nitin19011/milo-hardware/cad/generation/README.txt

Run generation scripts from this folder so their work/ and outputs/ paths resolve.
Original battery sleeve is in inputs/.
Historical scripts are retained for provenance; some previews still refer to original machine-specific fonts/paths and may need adaptation.
Existing printable STL files are under cad/glove, cad/mic and cad/battery.
Do not use MakerBot jobs on another printer without checking settings.
