nitin19011/milo-hardware/docs/analysis/candidate_data_20261025/README.txt

25 OCTOBER CANDIDATE DATA REVIEW

Original recording ZIP unchanged.
141 accepted gesture brackets, 603.043 seconds explicit everyday activity.
All IMU reads valid, no clipping, no flex ADC rails, no firmware queue drops.
21 observed forward-gap samples include reordering; only 13 unique sequence numbers are absent.
One restart occurred before the first gesture label.

Hold 4 short Come and 5 short overhand brackets for operator review; do not relabel them as negatives.
The continuous raw stream and nearby context retain motion outside some short brackets.
Remaining 132 gesture brackets are provisionally unflagged, not a claim of perfect labels.
No independent held-out session is present. No detector has been trained or 99% recall established.
