nitin19011/milo-hardware/cad/battery/battery_cap_preview.png

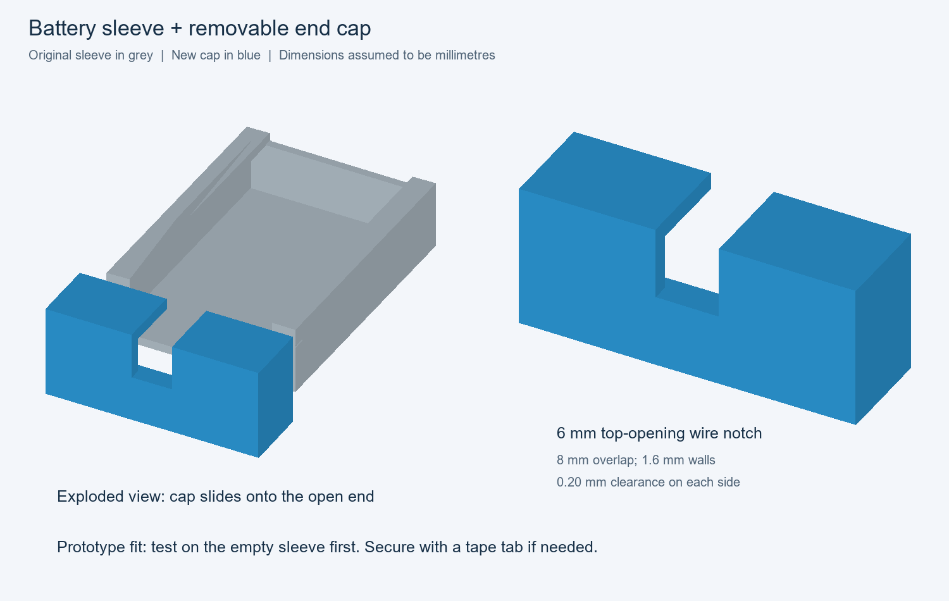
cad/battery/battery_cap_preview.png
