nitin19011/milo-hardware/cad/battery/Battery_flush_preview.png

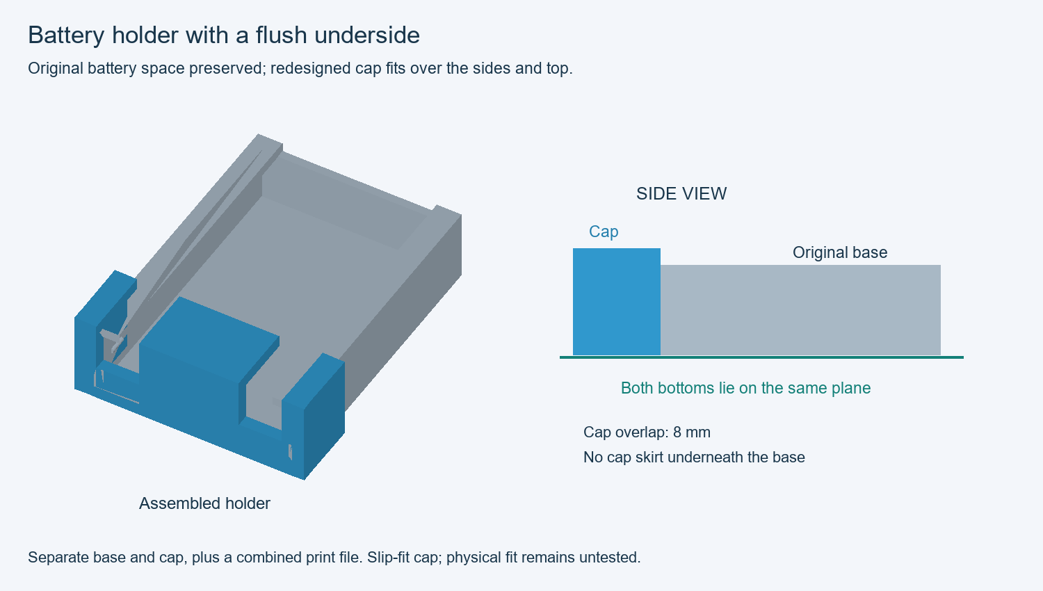
cad/battery/Battery_flush_preview.png
