nitin19011/milo-hardware/cad/glove/Glove_ESP_housing_labelled_concept.png

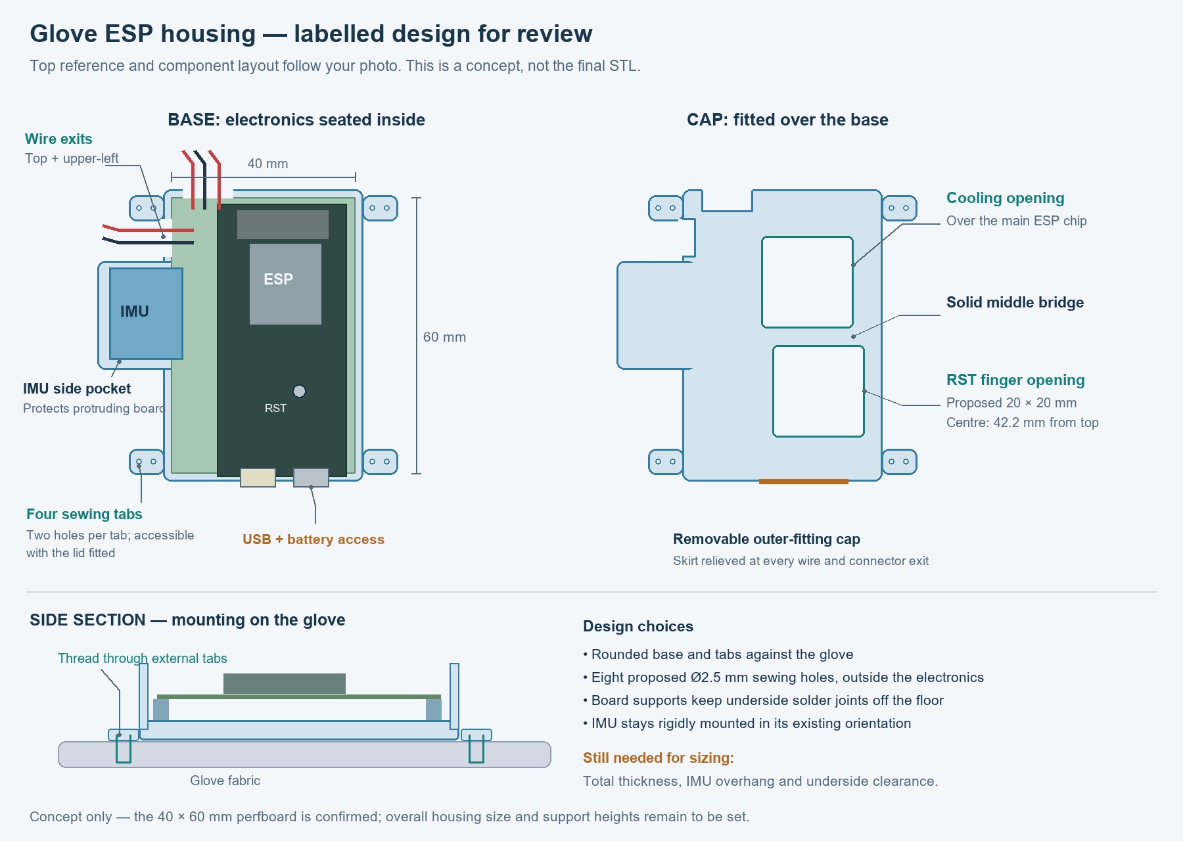
cad/glove/Glove_ESP_housing_labelled_concept.png
