nitin19011/milo-hardware/cad/glove/Glove_ESP_housing_labelled_concept_v2.png

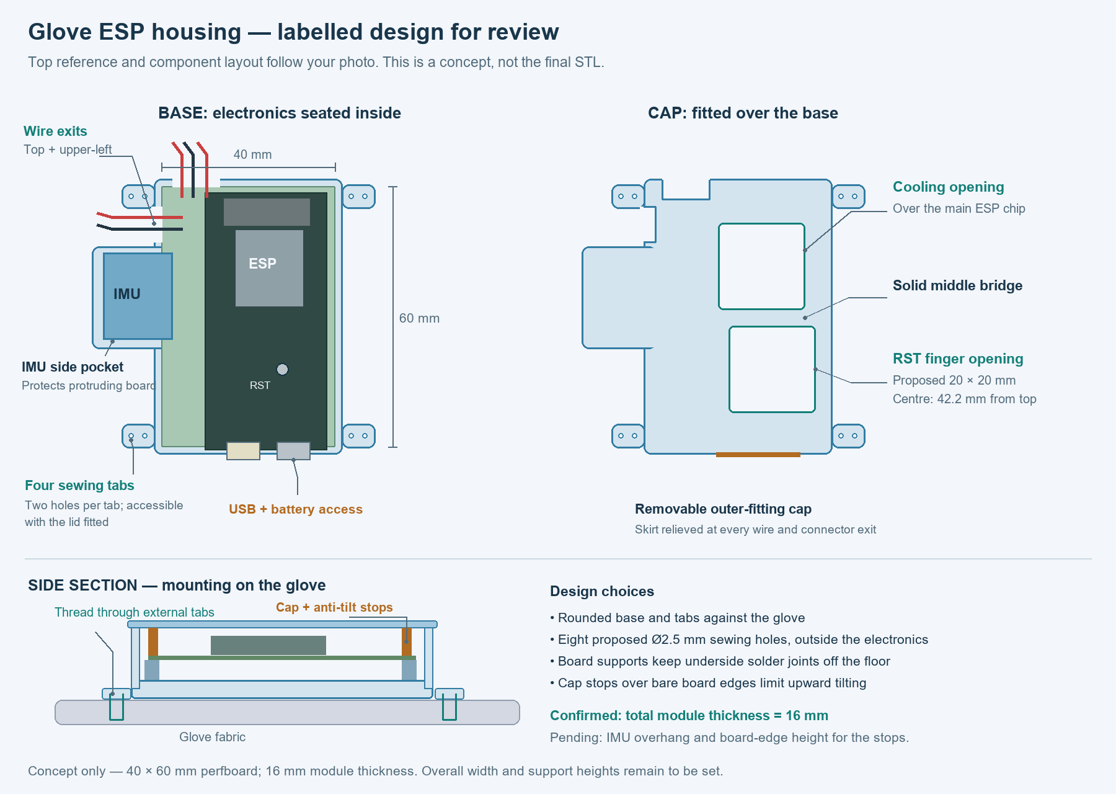
cad/glove/Glove_ESP_housing_labelled_concept_v2.png
