nitin19011/milo-hardware/cad/glove/Glove_ESP_IMU_vent_concept_v4.png

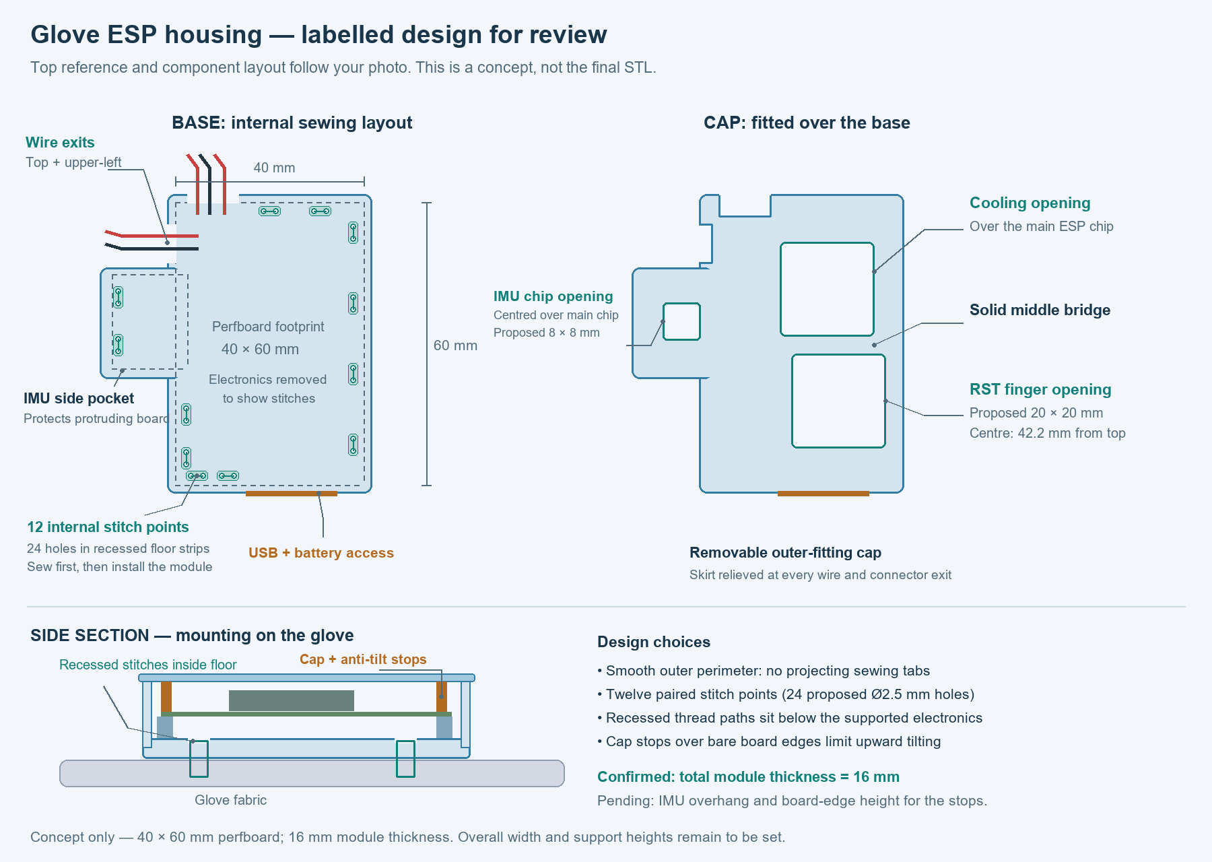
cad/glove/Glove_ESP_IMU_vent_concept_v4.png
