nitin19011/milo-hardware/cad/glove/Glove_housing_cap_v2_preview.png

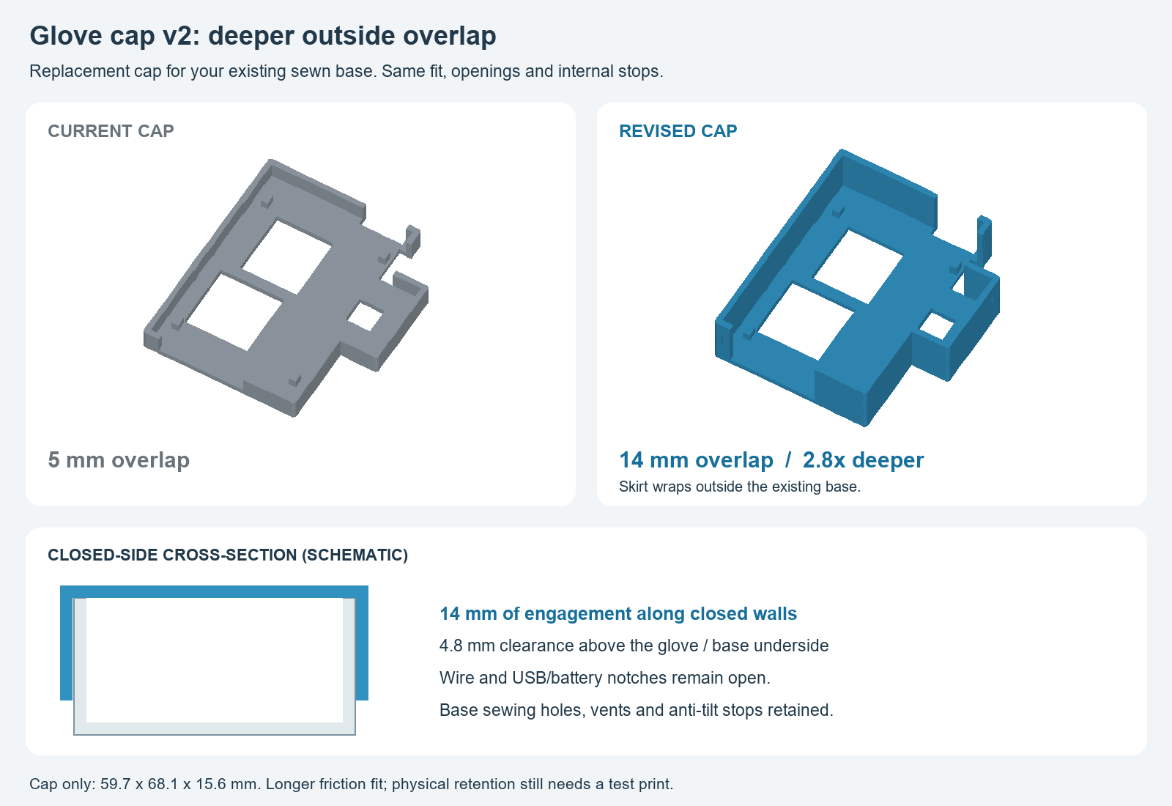
cad/glove/Glove_housing_cap_v2_preview.png
