nitin19011/milo-hardware/cad/glove/Glove_housing_v1_preview.png

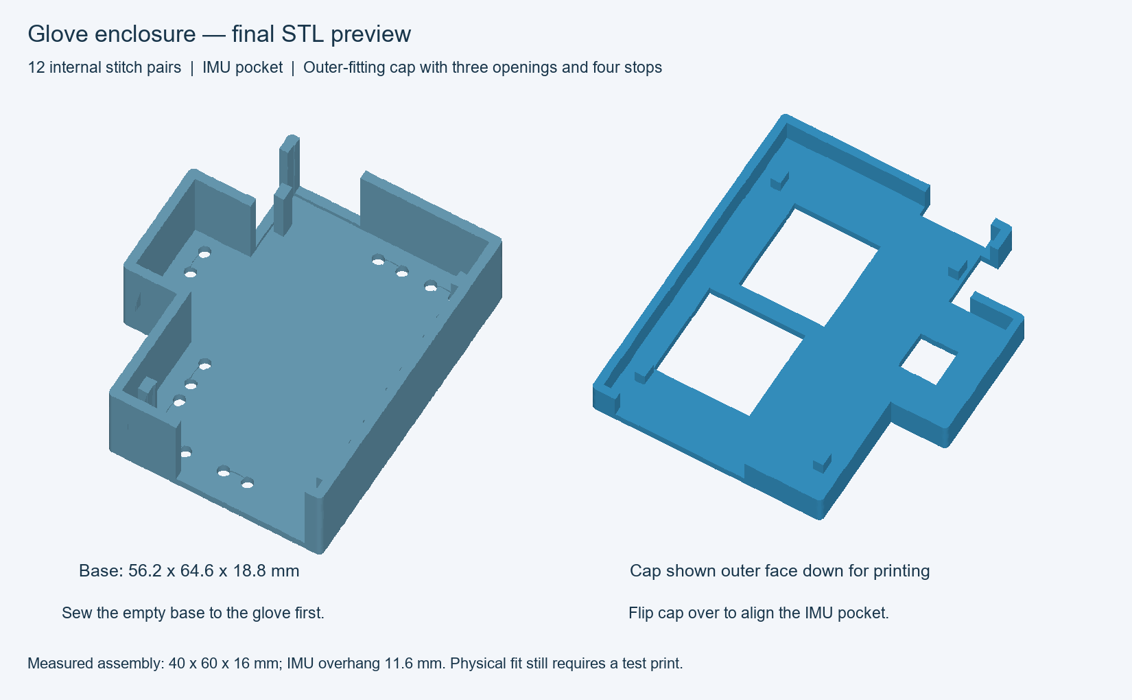
cad/glove/Glove_housing_v1_preview.png
