nitin19011/milo-hardware/cad/mic/Mic_cap_v4_preview.png

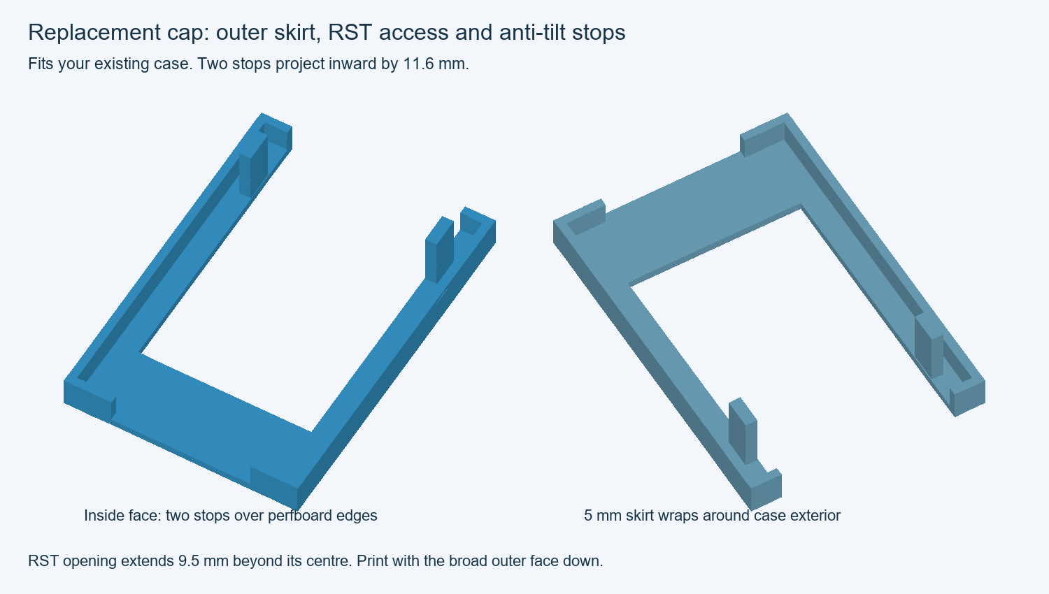
cad/mic/Mic_cap_v4_preview.png
