nitin19011/milo-hardware/cad/mic/Mic_cap_v5_preview.png

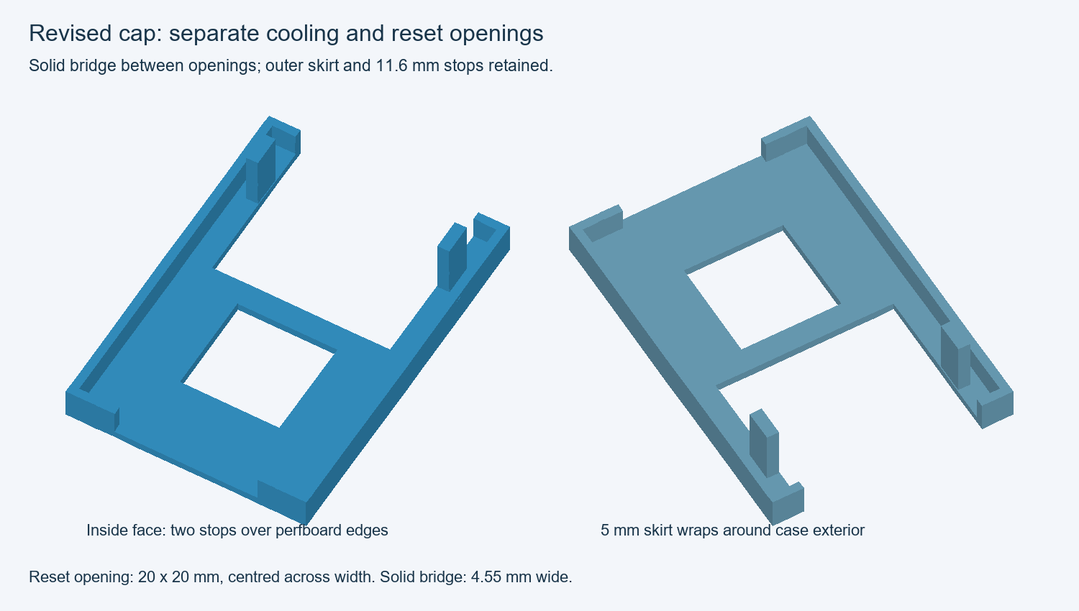
cad/mic/Mic_cap_v5_preview.png
