nitin19011/milo-hardware/cad/mic/mic_enclosure_concept.png

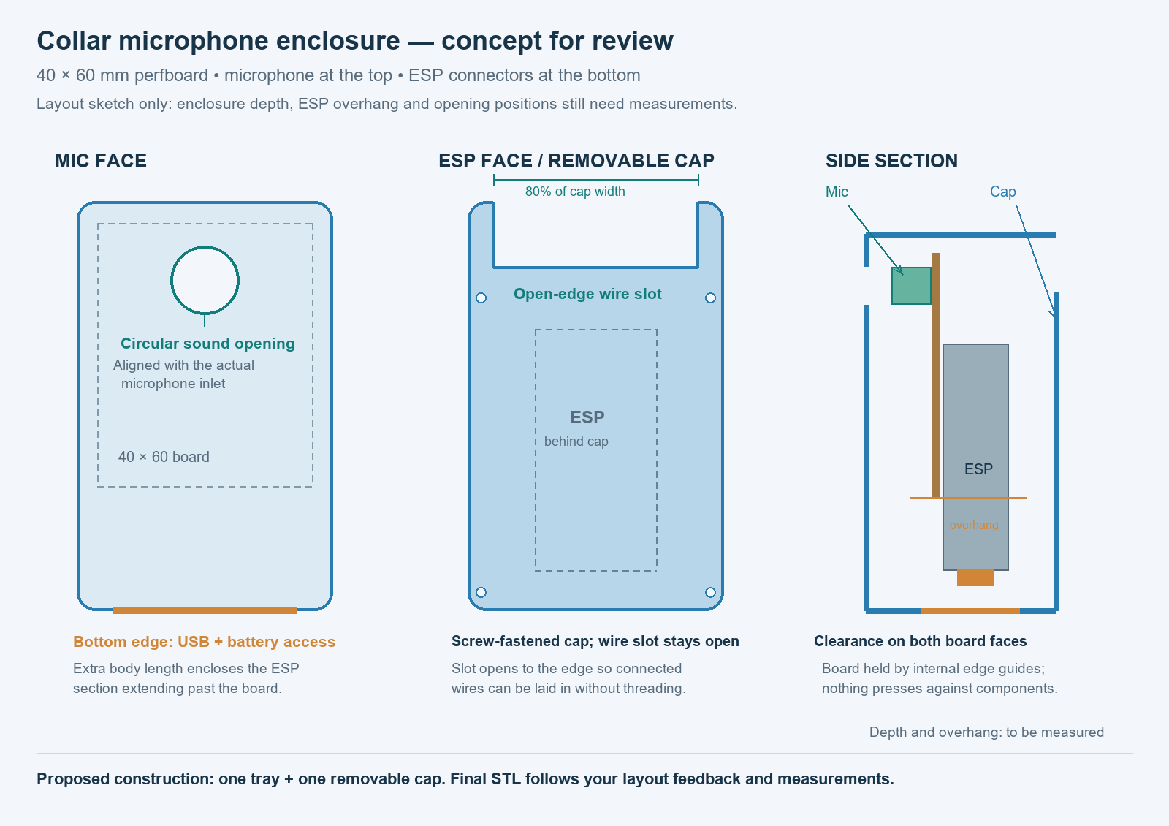
cad/mic/mic_enclosure_concept.png
