nitin19011/milo-hardware/cad/mic/mic_enclosure_concept_v2.png

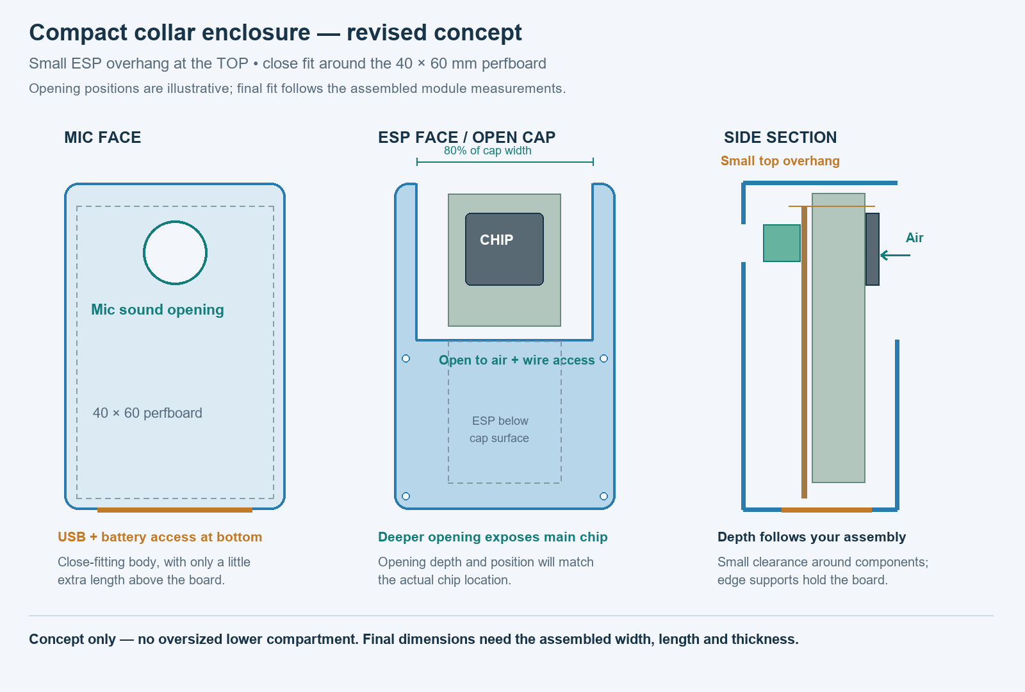
cad/mic/mic_enclosure_concept_v2.png
