nitin19011/milo-hardware/cad/mic/necklace_v3_preview.png

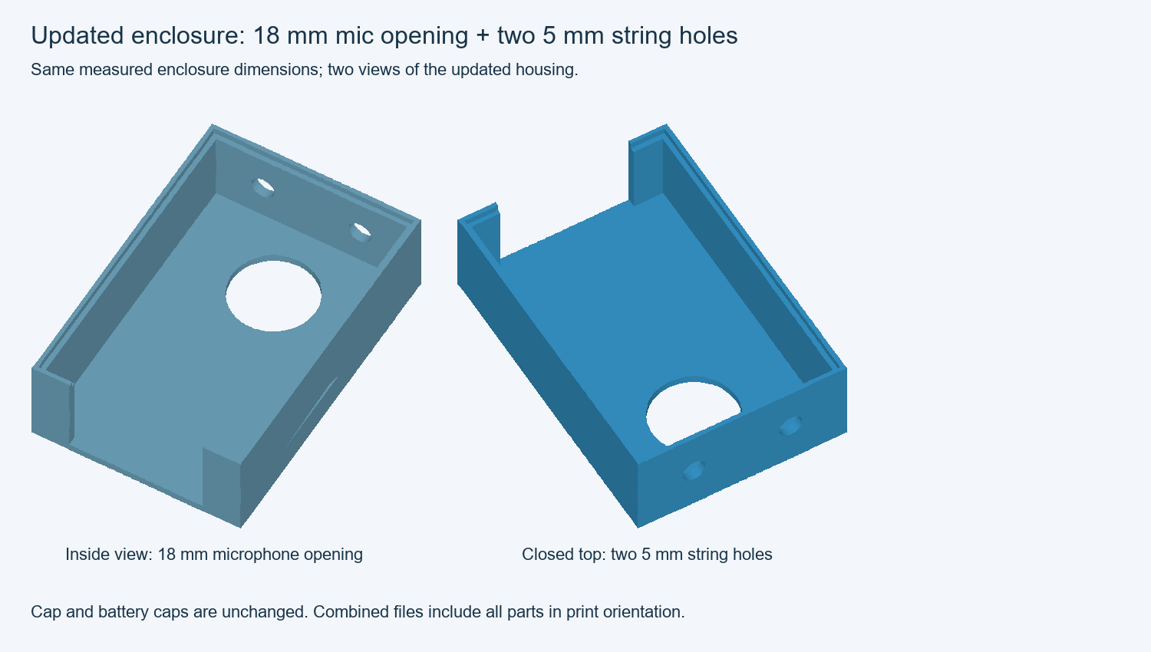
cad/mic/necklace_v3_preview.png
