nitin19011/milo-hardware/docs/architecture/Page_1_Preview.png

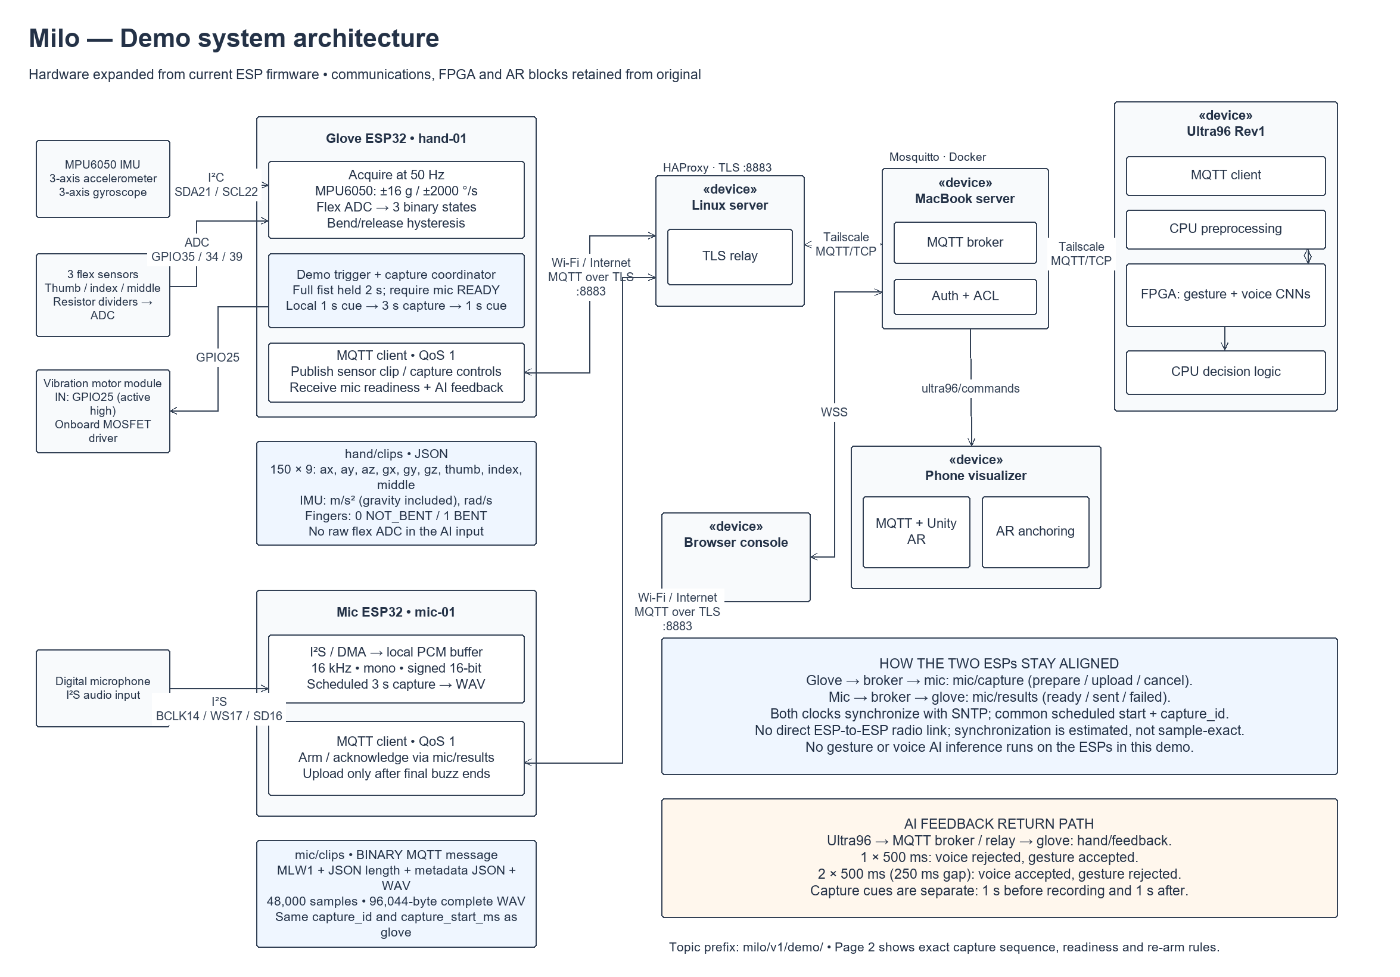
docs/architecture/Page_1_Preview.png
