nitin19011/milo-hardware/docs/architecture/Page_2_Preview.png

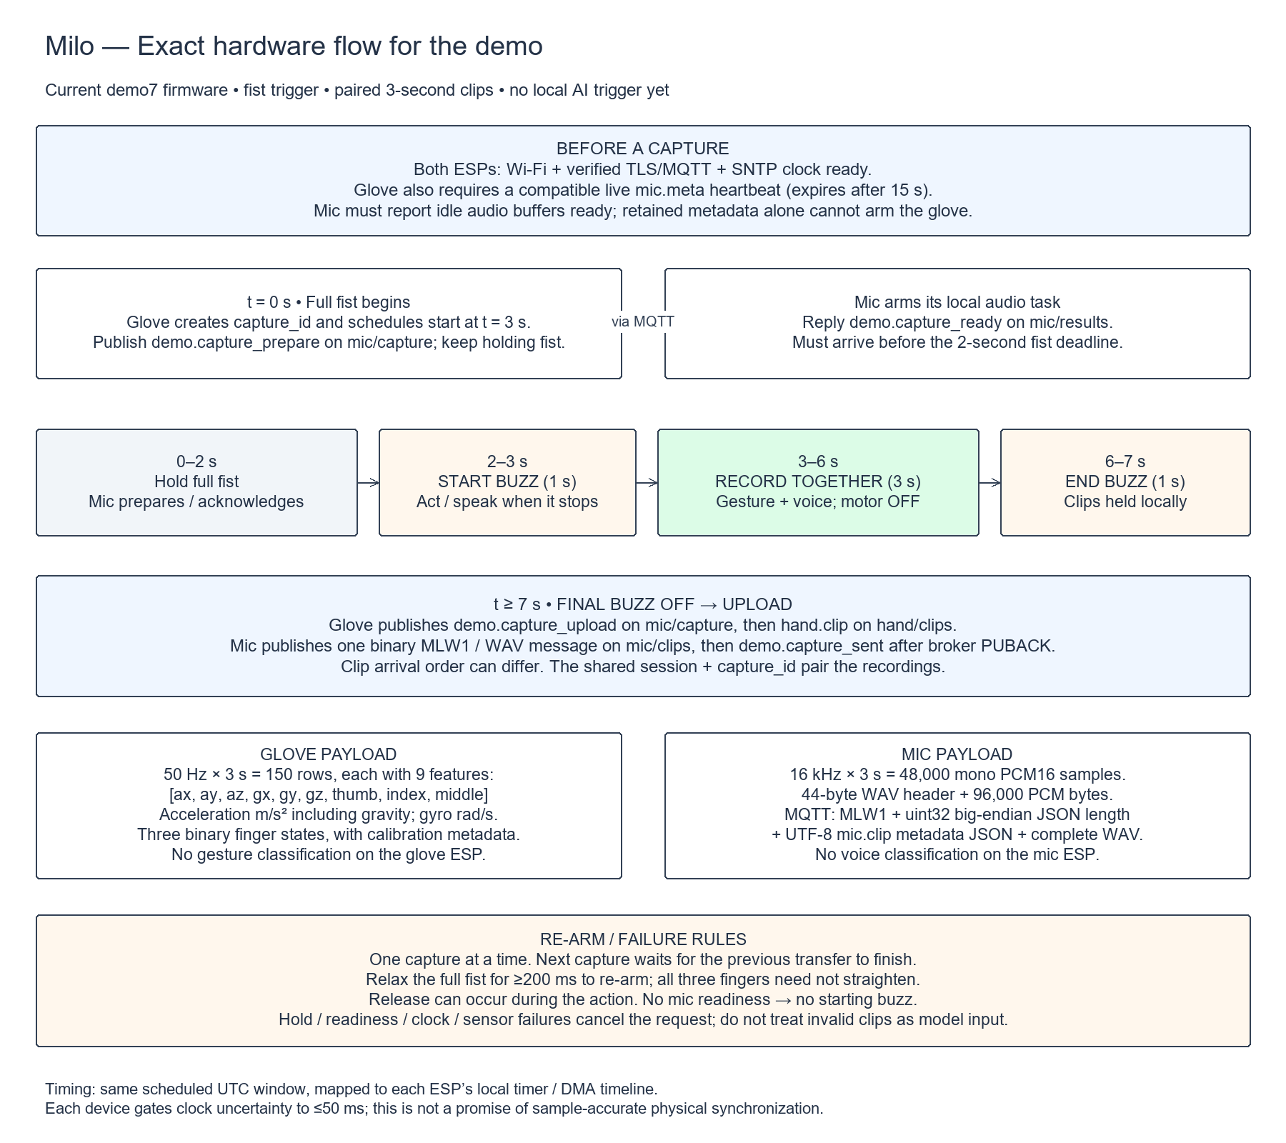
docs/architecture/Page_2_Preview.png
