nitin19011/milo-hardware/cad/battery/LiPo_1_housing_2_caps.stl

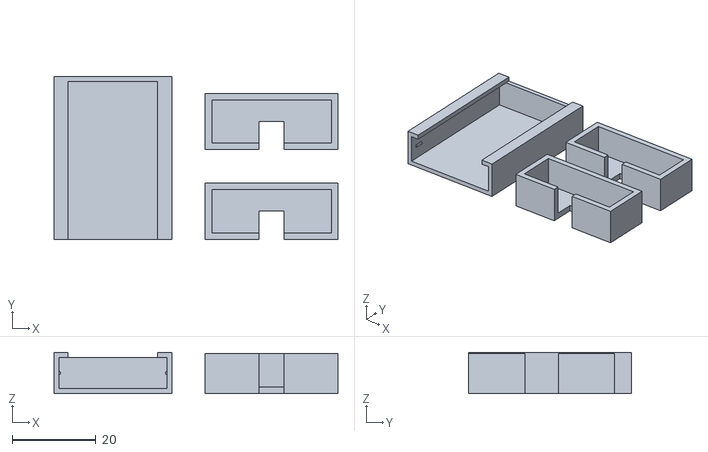
[picture p15: CAD file, 2026-10-27]
cad/battery/LiPo_1_housing_2_caps.stl
68.0 x 39.0 x 9.90
