nitin19011/milo-hardware/cad/generation/inputs/LiPo_600mAh_slide_sleeve.stl

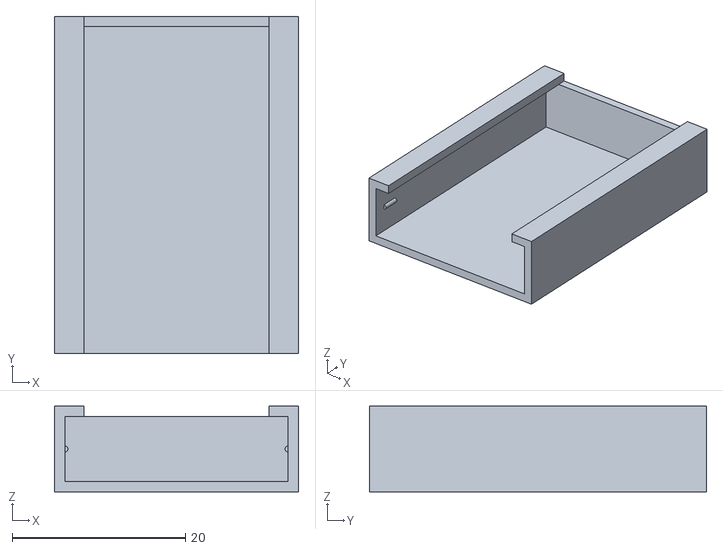
[picture p16: CAD file, 2026-10-27]
cad/generation/inputs/LiPo_600mAh_slide_sleeve.stl
28.2 x 39.0 x 9.90
