nitin19011/milo-hardware/cad/glove/Glove_housing_base_v1.stl

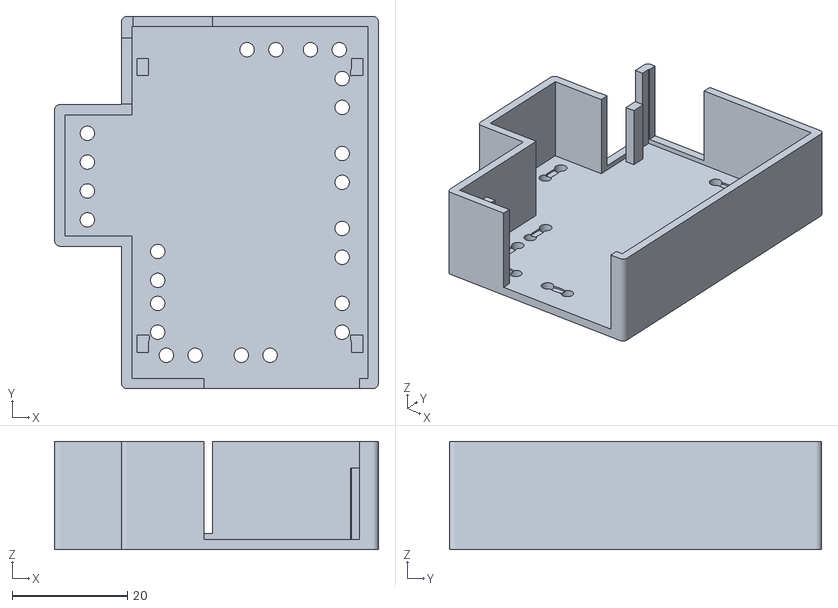
[picture p17: CAD file, 2026-10-27]
cad/glove/Glove_housing_base_v1.stl
56.2 x 64.6 x 18.8
