nitin19011/milo-hardware/cad/battery/Battery_flush_base_and_cap.stl

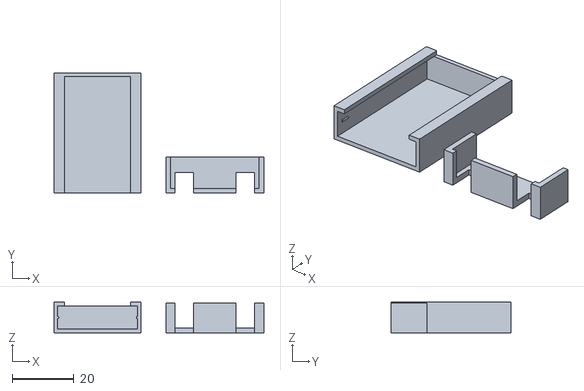
[picture p19: CAD file, 2026-10-27]
cad/battery/Battery_flush_base_and_cap.stl
68.0 x 39.0 x 9.90
