nitin19011/milo-hardware/cad/glove/Glove_housing_cap_v1.stl

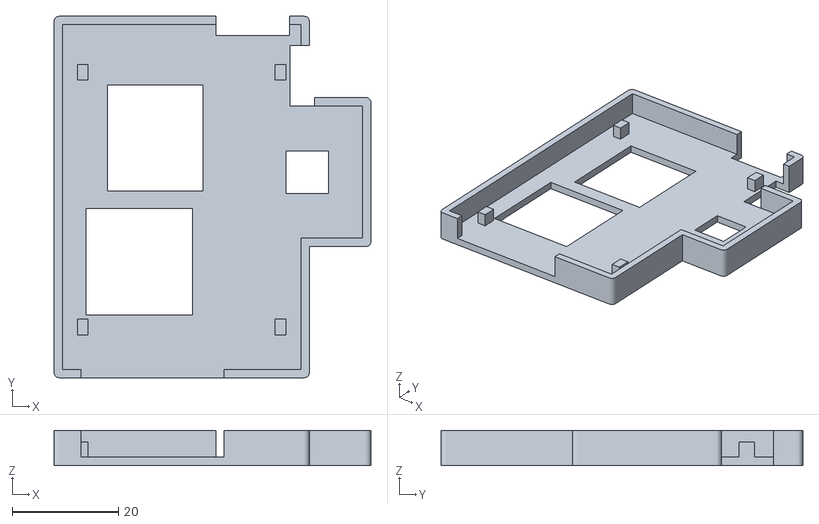
[picture p20: CAD file, 2026-10-27]
cad/glove/Glove_housing_cap_v1.stl
59.7 x 68.1 x 6.60
