nitin19011/milo-hardware/cad/mic/Mic_cap_v4_outer_skirt_RST_stops.stl

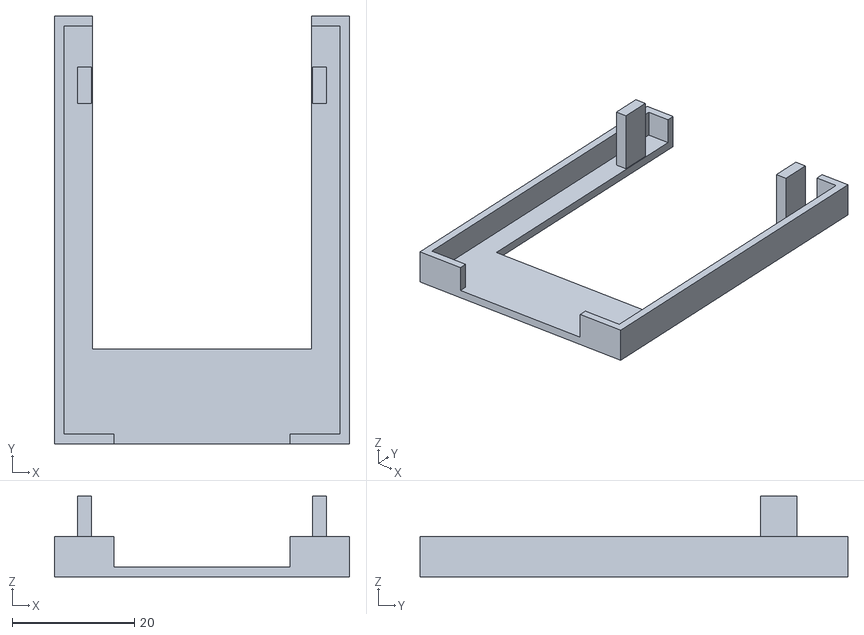
[picture p21: CAD file, 2026-10-27]
cad/mic/Mic_cap_v4_outer_skirt_RST_stops.stl
48.3 x 70.1 x 13.2
