nitin19011/milo-hardware/cad/battery/LiPo_600mAh_cap_standard.stl

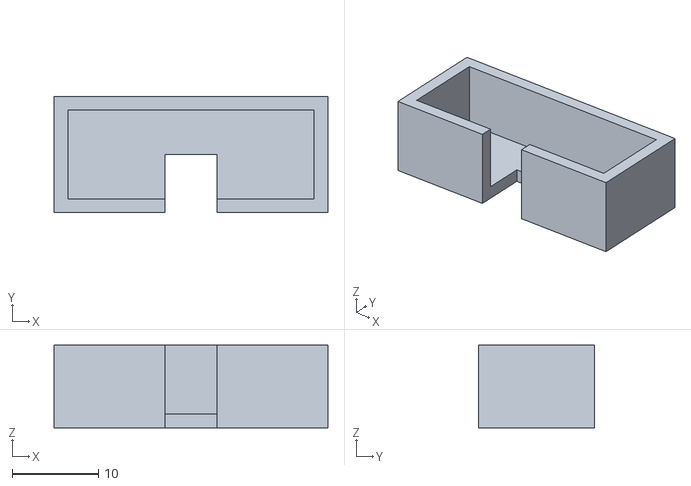
[picture p22: CAD file, 2026-10-27]
cad/battery/LiPo_600mAh_cap_standard.stl
31.8 x 13.5 x 9.60
