nitin19011/milo-hardware/cad/glove/Glove_housing_base_and_cap_v1.stl

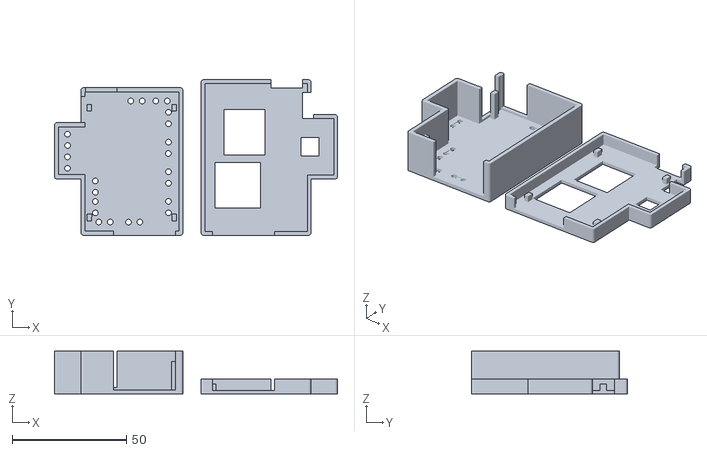
[picture p23: CAD file, 2026-10-27]
cad/glove/Glove_housing_base_and_cap_v1.stl
123.9 x 68.1 x 18.8
