nitin19011/milo-hardware/cad/mic/Necklace_v3_combined_2_battery_caps.stl

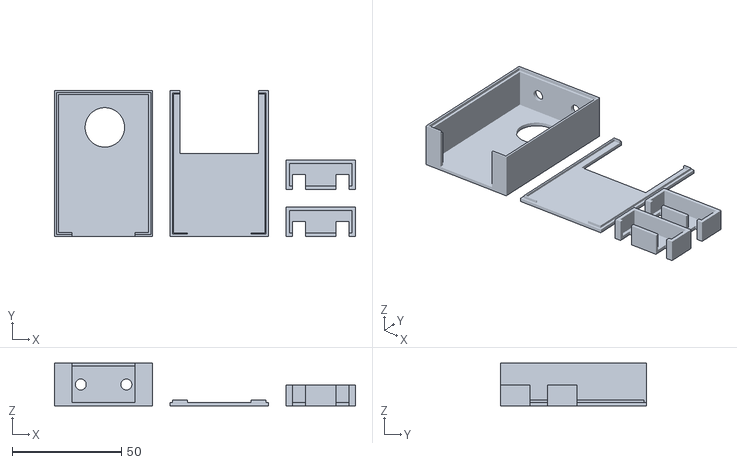
[picture p24: CAD file, 2026-10-27]
cad/mic/Necklace_v3_combined_2_battery_caps.stl
137.5 x 66.6 x 19.6
