nitin19011/milo-hardware/cad/glove/Glove_housing_cap_v2_deep_skirt.stl

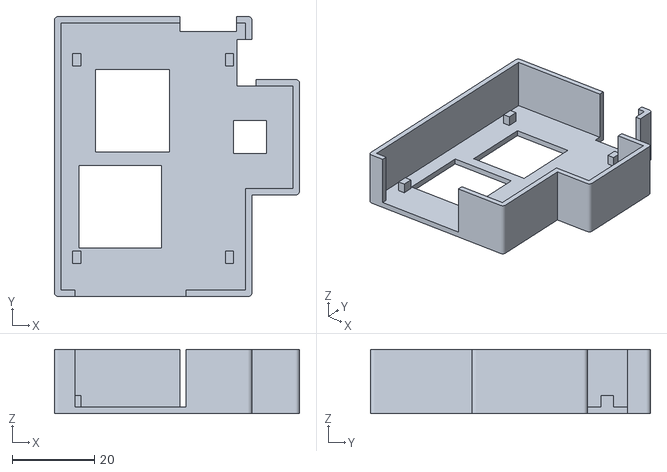
[picture p25: CAD file, 2026-10-27]
cad/glove/Glove_housing_cap_v2_deep_skirt.stl
59.7 x 68.1 x 15.6
