nitin19011/milo-hardware/cad/mic/Mic_cap_NECKLACE_v3.stl

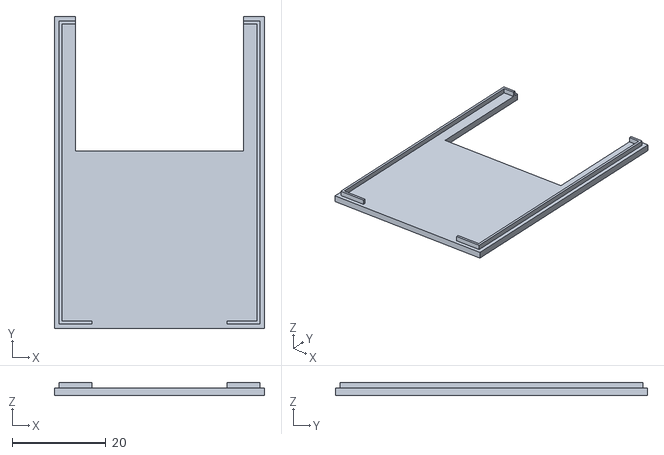
[picture p27: CAD file, 2026-10-27]
cad/mic/Mic_cap_NECKLACE_v3.stl
44.8 x 66.6 x 2.80
