nitin19011/milo-hardware/cad/battery/Battery_cap_two_wire_notches.stl

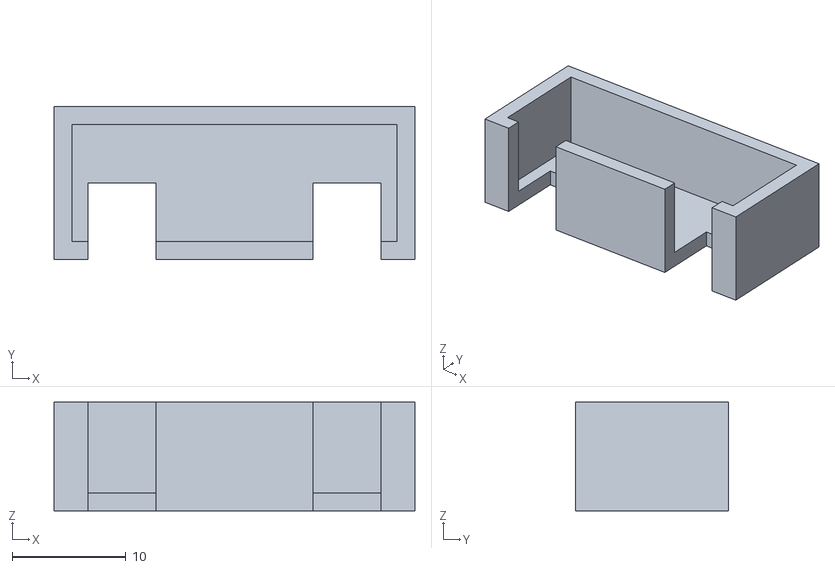
[picture p28: CAD file, 2026-10-27]
cad/battery/Battery_cap_two_wire_notches.stl
31.8 x 13.5 x 9.60
