nitin19011/milo-hardware/cad/mic/Mic_open_cap_PROTOTYPE.stl

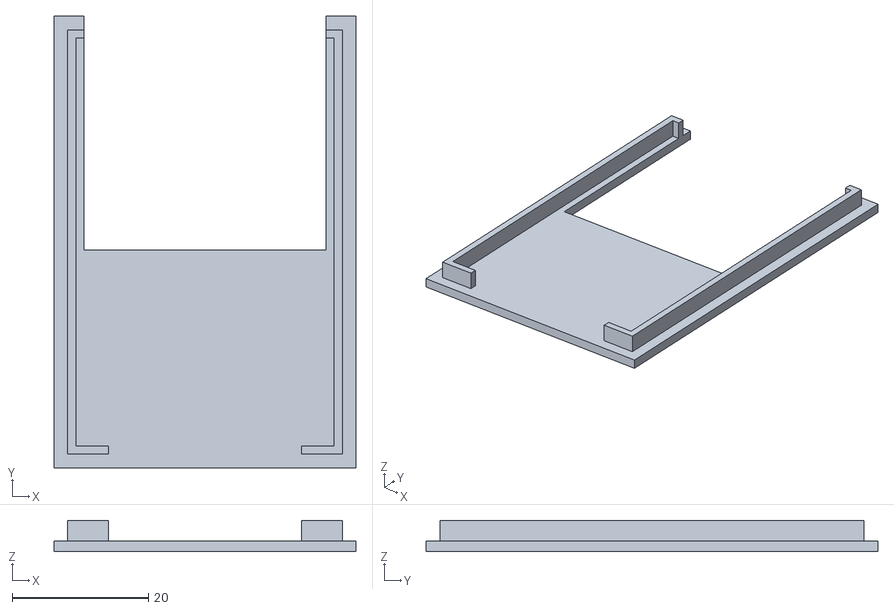
[picture p29: CAD file, 2026-10-27]
cad/mic/Mic_open_cap_PROTOTYPE.stl
44.4 x 66.4 x 4.60
