nitin19011/milo-hardware/cad/battery/LiPo_600mAh_cap_looser.stl

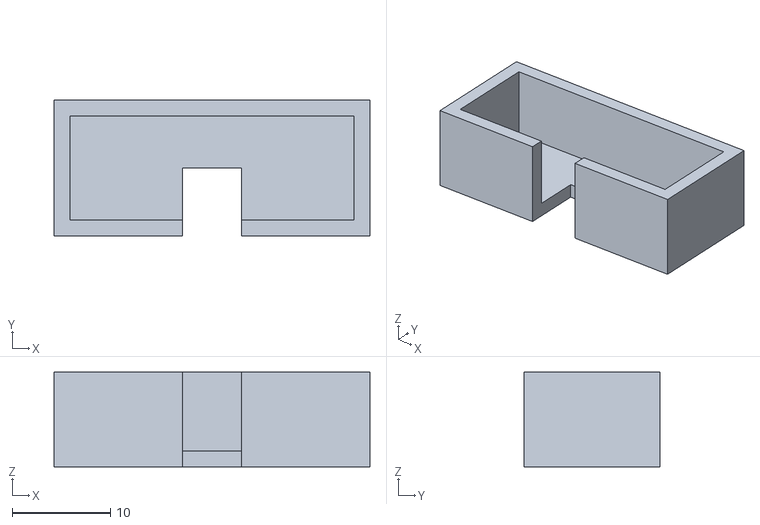
[picture p30: CAD file, 2026-10-27]
cad/battery/LiPo_600mAh_cap_looser.stl
32.1 x 13.8 x 9.60
