nitin19011/milo-hardware/cad/battery/Battery_flush_cap.stl

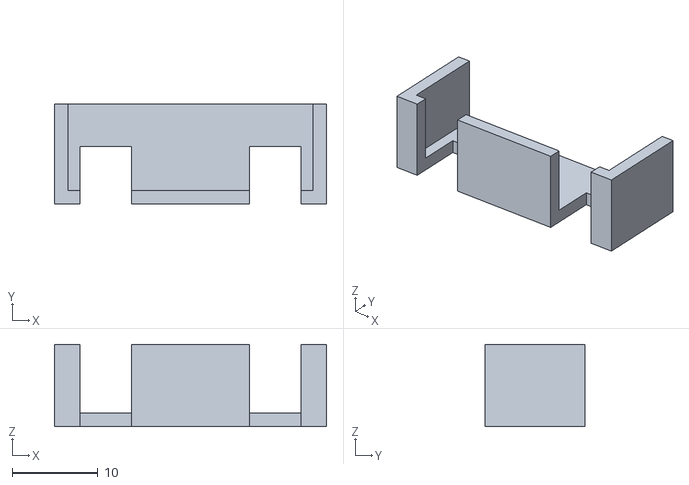
[picture p31: CAD file, 2026-10-27]
cad/battery/Battery_flush_cap.stl
31.8 x 11.7 x 9.60
