nitin19011/milo-hardware/cad/mic/Mic_housing_PROTOTYPE.stl

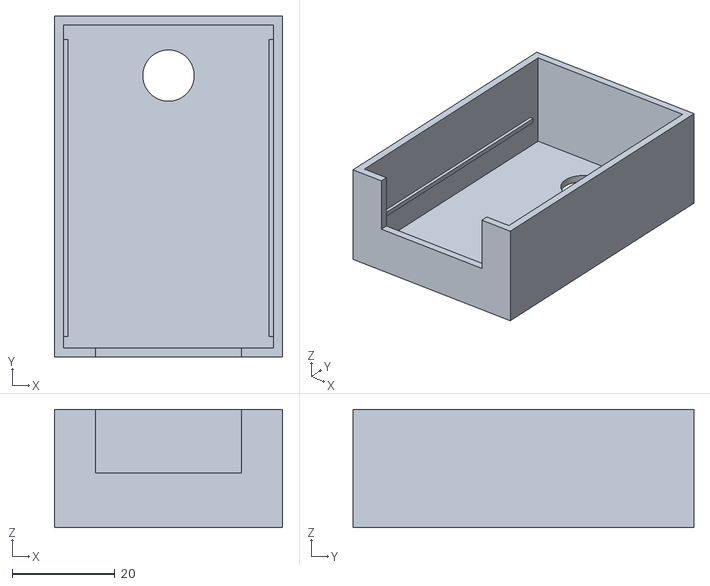
[picture p32: CAD file, 2026-10-27]
cad/mic/Mic_housing_PROTOTYPE.stl
44.4 x 66.4 x 23.0
