nitin19011/milo-hardware/cad/mic/Mic_housing_and_caps_2_battery_caps.stl

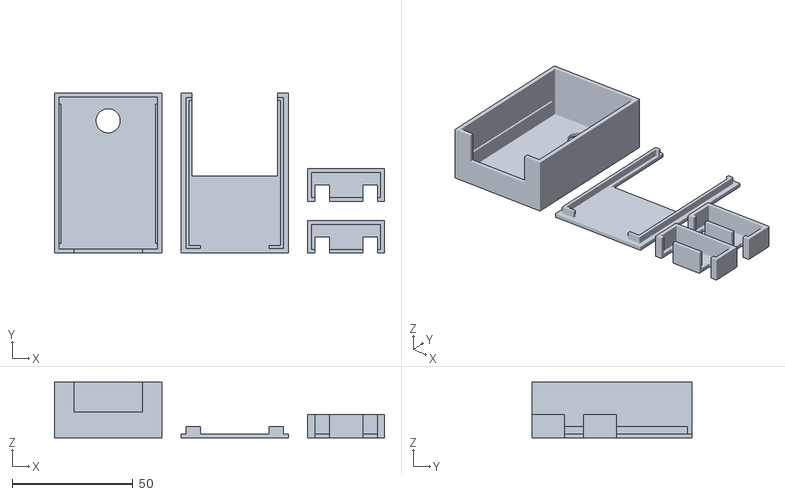
[picture p33: CAD file, 2026-10-27]
cad/mic/Mic_housing_and_caps_2_battery_caps.stl
136.6 x 66.4 x 23.0
