nitin19011/milo-hardware/cad/mic/Mic_cap_v5_split_openings.stl

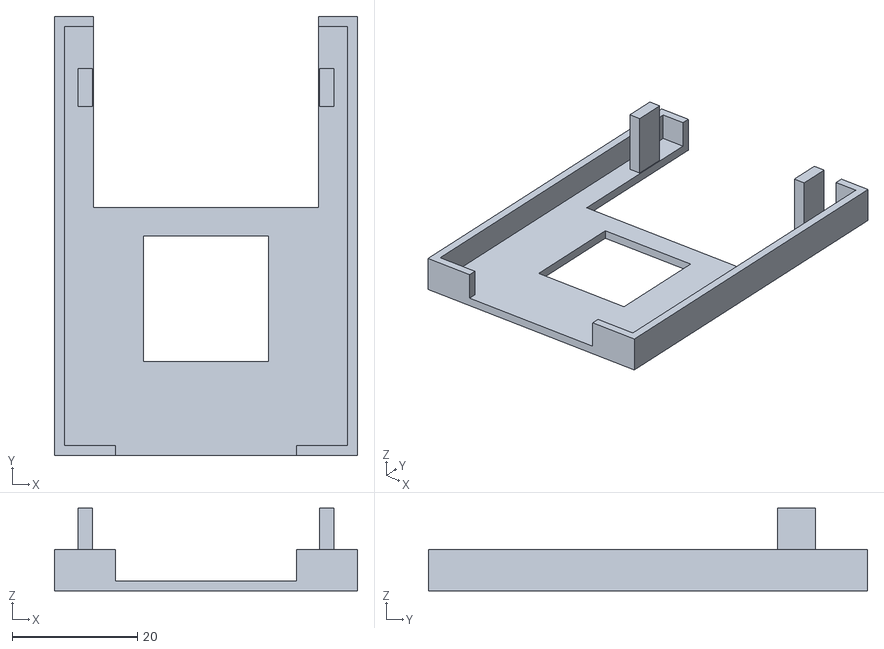
[picture p34: CAD file, 2026-10-27]
cad/mic/Mic_cap_v5_split_openings.stl
48.3 x 70.1 x 13.2
