nitin19011/milo-hardware/cad/mic/Measured_v2_combined_1_battery_cap.stl

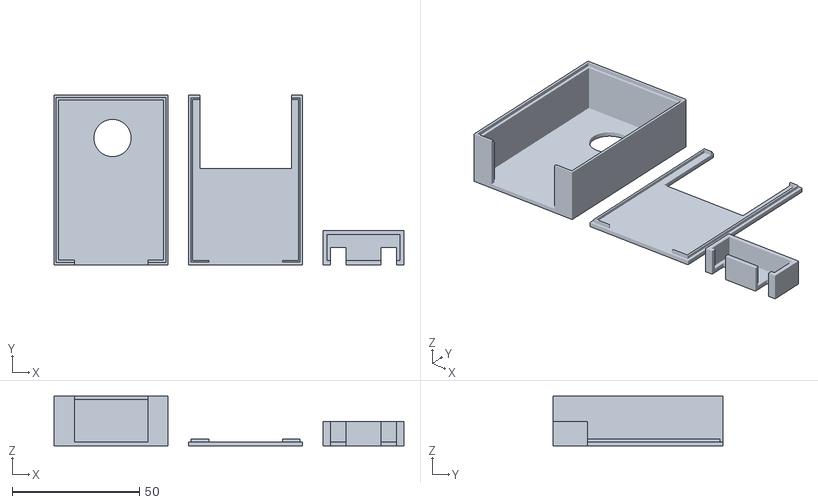
[picture p35: CAD file, 2026-10-27]
cad/mic/Measured_v2_combined_1_battery_cap.stl
137.5 x 66.6 x 19.6
