nitin19011/milo-hardware/cad/mic/Necklace_v3_combined_1_battery_cap.stl

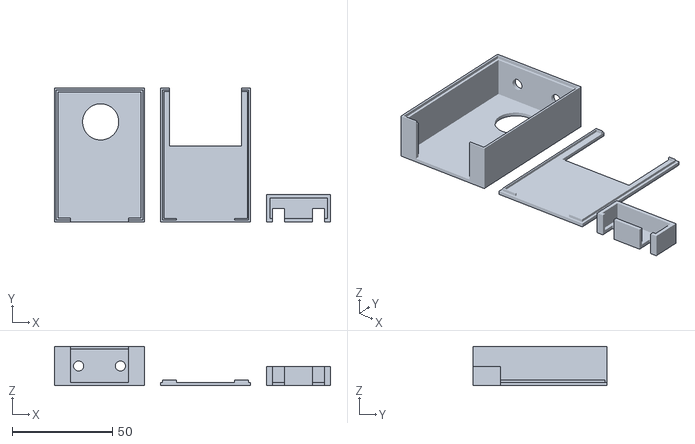
[picture p36: CAD file, 2026-10-27]
cad/mic/Necklace_v3_combined_1_battery_cap.stl
137.5 x 66.6 x 19.6
