nitin19011/milo-hardware/(list of files, cad)

Other CAD files:
cad/battery/Battery_flush_sewable_base.stl
cad/mic/Measured_v2_combined_2_battery_caps.stl
cad/battery/Battery_flush_sewable_base_and_cap.stl
cad/mic/Mic_housing_MEASURED_v2.stl
