nitin19011/milo-hardware/cad/mic/enclosure_print_preview.png

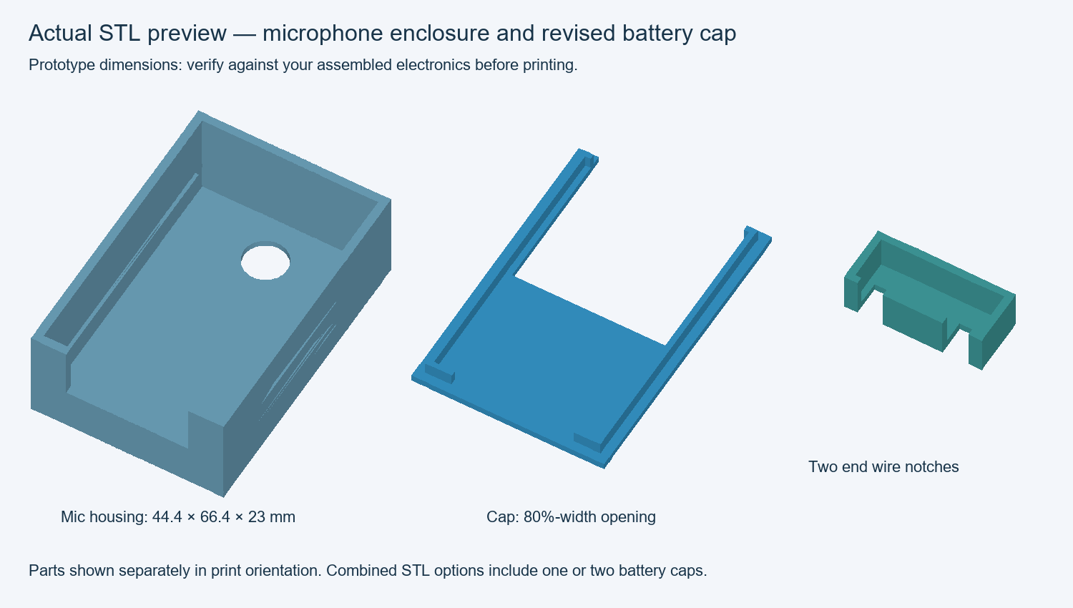
cad/mic/enclosure_print_preview.png
