nitin19011/milo-hardware/prototypes/candidate_detector_latest/VALIDATION.txt

25 October 2026 - V2 hard-negative update

FireBeetle-ESP32 compile/link passed. ESP32 core 3.3.11 / ArduinoJson 7.4.3.
Flash: 972648 bytes (74%). Static RAM: 62192 bytes (18%).

Native C++ versus Python on 1085 real recorded windows:
maximum feature error 0; maximum score error 1.19209e-07; threshold disagreements 0.
The selected model uses 45 features, 32 trees, 2090 nodes and threshold 0.313071883.

14 desktop checks passed, including:
- USB-compatible parsing and real local UDP reception;
- actual detector score and visible POSSIBLE ACTION UI indicator;
- clear rejection of an old v1 sketch using the firmware version marker;
- annotations, discard, class advance and asynchronous ZIP export;
- two overlapping 150-row windows preserved as two windows in one activity group;
- incomplete windows remain invalid rather than silently filled;
- layout fits on a 1280x800 desktop.

Retraining used only explicitly labelled new background, with guarded contiguous
fit/calibration/check time blocks. Original unknown mixed live session was not
used as negative. Nine ambiguous original actions remain outside fitting.
54 original non-fitting brackets were used for development/threshold selection,
not independent recall validation. Held negative time block is only 22.6 seconds.
See training_report.json for all model comparisons and limitations.

No physical glove was flashed by the assistant. Fresh worn-glove action recall,
real inference timing and false activity still need checking. No 99% guarantee.
No mic/MQTT/Ultra96 integration is provided by this glove-only prototype.
