nitin19011/milo-hardware/calibration/reference_20261023/readings.csv

repeat | pose | elapsed_ms | thumb | index | middle
1 | relaxed | 101 | 1443 | 1493 | 3453
1 | relaxed | 203 | 1442 | 1494 | 3454
1 | relaxed | 305 | 1443 | 1493 | 3453
1 | relaxed | 407 | 1442 | 1491 | 3452
1 | relaxed | 509 | 1442 | 1493 | 3453
1 | relaxed | 611 | 1442 | 1491 | 3451
1 | relaxed | 714 | 1443 | 1493 | 3451
1 | relaxed | 815 | 1442 | 1492 | 3452
1 | relaxed | 917 | 1442 | 1493 | 3451
1 | relaxed | 1019 | 1442 | 1493 | 3452
1 | relaxed | 1122 | 1442 | 1492 | 3453
1 | relaxed | 1223 | 1443 | 1493 | 3452
1 | relaxed | 1326 | 1442 | 1492 | 3451
1 | relaxed | 1427 | 1443 | 1491 | 3457
1 | relaxed | 1529 | 1442 | 1493 | 3455
1 | relaxed | 1631 | 1442 | 1493 | 3453
1 | relaxed | 1733 | 1442 | 1491 | 3451
1 | relaxed | 1837 | 1443 | 1492 | 3454
1 | relaxed | 1937 | 1442 | 1492 | 3454
1 | relaxed | 2040 | 1443 | 1493 | 3454
1 | relaxed | 2141 | 1441 | 1491 | 3451
1 | relaxed | 2243 | 1441 | 1492 | 3453
1 | relaxed | 2345 | 1441 | 1491 | 3452
1 | relaxed | 2448 | 1442 | 1492 | 3451
1 | relaxed | 2549 | 1441 | 1492 | 3453
1 | relaxed | 2652 | 1442 | 1492 | 3451
1 | relaxed | 2753 | 1442 | 1492 | 3454
1 | relaxed | 2855 | 1442 | 1491 | 3453
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
