nitin19011/milo-hardware/collectors/history/Milo_Gesture_Collection/review_template.html

# Milo gesture waveform review

Recording

Click a plot to mark the selected event. Exact release timing is a human annotation; a detected candidate is only a suggestion.

Action starts Finger release (throws) Action ends

ThumbIndexMiddle

Finger scale: 0 = this session's straight hand; 1 = this session's comfortable fist. Values are not clipped.

Start ms Release ms End ms

Keep this correctly performed gesture I reviewed the signals and accept the warnings

Download annotations.json

Apply your downloaded annotations with: py review_session.py SESSION_FOLDER --annotations ANNOTATIONS_FILE. Hard faults remain quarantined. The reviewer shows all saved attempts, including rejected ones.
