nitin19011/milo-hardware/prototypes/history/candidate_detector_v1/GloveCandidateDetector/CandidateModel.h

#pragma once
#include <stdint.h>
// Generated small forest; no TFLite runtime or dynamic allocation.
static constexpr float MILO_TRIGGER_THRESHOLD=0.1f;
static constexpr int MILO_MODEL_FEATURES=39;
struct MiloNode { int16_t left,right; int8_t feature; float threshold,score; };
static const MiloNode MILO_TREE_0[] = {
{1,10,14,7.46749973f,0.5f},
{2,3,35,0.387499988f,0.0632010157f},
{-1,-1,-2,-2.0f,0.0f},
{4,7,2,5.0791502f,0.764725853f},
{5,6,33,0.275000006f,0.994536122f},
{-1,-1,-2,-2.0f,0.97326492f},
{-1,-1,-2,-2.0f,1.0f},
{8,9,11,0.0478000008f,0.0f},
{-1,-1,-2,-2.0f,0.0f},
{-1,-1,-2,-2.0f,0.0f},
{11,24,26,9.09675026f,0.790664457f},
{12,19,35,0.162499994f,0.433046043f},
{13,16,25,2.56844997f,0.0811857992f},
{14,15,19,0.428499997f,0.029491187f},
{-1,-1,-2,-2.0f,0.204053901f},
{-1,-1,-2,-2.0f,0.0f},
{17,18,22,0.454450011f,0.657064722f},
{-1,-1,-2,-2.0f,0.97326492f},
{-1,-1,-2,-2.0f,0.0f},
{20,21,1,1.62279999f,0.850181598f},
{-1,-1,-2,-2.0f,0.0f},
{22,23,16,8.42335033f,0.943287769f},
{-1,-1,-2,-2.0f,0.971794298f},
{-1,-1,-2,-2.0f,0.0f},
{25,32,9,3.25584984f,0.934262088f},
{26,29,23,0.741899967f,0.835551525f},
{27,28,1,5.60610008f,0.760912081f},
{-1,-1,-2,-2.0f,0.0f},
{-1,-1,-2,-2.0f,0.83033419f},
{30,31,5,-0.622799993f,1.0f},
{-1,-1,-2,-2.0f,1.0f},
{-1,-1,-2,-2.0f,1.0f},
{33,34,28,17.4566994f,0.980923569f},
{-1,-1,-2,-2.0f,0.0f},
{35,36,7,5.35605001f,0.98609665f},
{-1,-1,-2,-2.0f,0.0f},
{-1,-1,-2,-2.0f,0.988941395f},
};
static const MiloNode MILO_TREE_1[] = {
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
{-1,-1,-2,-2.0f,0.0f},
{20,21,10,3.09625006f,0.837198516f},
{-1,-1,-2,-2.0f,0.958576739f},
{-1,-1,-2,-2.0f,0.0f},
{23,28,18,1.73539996f,0.914625919f},
{24,27,5,1.48819995f,0.811620677f},
{25,26,11,1.25154996f,0.835663261f},
{-1,-1,-2,-2.0f,0.955328225f},
{-1,-1,-2,-2.0f,0.734596524f},
{-1,-1,-2,-2.0f,0.0f},
{29,32,16,18.637249f,0.985800109f},
{30,31,26,9.4951992f,0.991903576f},
{-1,-1,-2,-2.0f,0.9025f},
{-1,-1,-2,-2.0f,0.996014715f},
{33,34,14,29.4678497f,0.0f},
{-1,-1,-2,-2.0f,0.0f},
{-1,-1,-2,-2.0f,0.0f},
};
static inline float miloPredict(const float *x) {
float score=0.0f;
{ int n=0; while(MILO_TREE_0[n].feature>=0){ const MiloNode &v=MILO_TREE_0[n];n=x[v.feature]<=v.threshold?v.left:v.right;}score+=MILO_TREE_0[n].score;}
{ int n=0; while(MILO_TREE_1[n].feature>=0){ const MiloNode &v=MILO_TREE_1[n];n=x[v.feature]<=v.threshold?v.left:v.right;}score+=MILO_TREE_1[n].score;}
{ int n=0; while(MILO_TREE_2[n].feature>=0){ const MiloNode &v=MILO_TREE_2[n];n=x[v.feature]<=v.threshold?v.left:v.right;}score+=MILO_TREE_2[n].score;}
{ int n=0; while(MILO_TREE_3[n].feature>=0){ const MiloNode &v=MILO_TREE_3[n];n=x[v.feature]<=v.threshold?v.left:v.right;}score+=MILO_TREE_3[n].score;}
{ int n=0; while(MILO_TREE_4[n].feature>=0){ const MiloNode &v=MILO_TREE_4[n];n=x[v.feature]<=v.threshold?v.left:v.right;}score+=MILO_TREE_4[n].score;}
{ int n=0; while(MILO_TREE_5[n].feature>=0){ const MiloNode &v=MILO_TREE_5[n];n=x[v.feature]<=v.threshold?v.left:v.right;}score+=MILO_TREE_5[n].score;}
{ int n=0; while(MILO_TREE_6[n].feature>=0){ const MiloNode &v=MILO_TREE_6[n];n=x[v.feature]<=v.threshold?v.left:v.right;}score+=MILO_TREE_6[n].score;}
{ int n=0; while(MILO_TREE_7[n].feature>=0){ const MiloNode &v=MILO_TREE_7[n];n=x[v.feature]<=v.threshold?v.left:v.right;}score+=MILO_TREE_7[n].score;}
{ int n=0; while(MILO_TREE_8[n].feature>=0){ const MiloNode &v=MILO_TREE_8[n];n=x[v.feature]<=v.threshold?v.left:v.right;}score+=MILO_TREE_8[n].score;}
{ int n=0; while(MILO_TREE_9[n].feature>=0){ const MiloNode &v=MILO_TREE_9[n];n=x[v.feature]<=v.threshold?v.left:v.right;}score+=MILO_TREE_9[n].score;}
{ int n=0; while(MILO_TREE_10[n].feature>=0){ const MiloNode &v=MILO_TREE_10[n];n=x[v.feature]<=v.threshold?v.left:v.right;}score+=MILO_TREE_10[n].score;}
{ int n=0; while(MILO_TREE_11[n].feature>=0){ const MiloNode &v=MILO_TREE_11[n];n=x[v.feature]<=v.threshold?v.left:v.right;}score+=MILO_TREE_11[n].score;}
{ int n=0; while(MILO_TREE_12[n].feature>=0){ const MiloNode &v=MILO_TREE_12[n];n=x[v.feature]<=v.threshold?v.left:v.right;}score+=MILO_TREE_12[n].score;}
{ int n=0; while(MILO_TREE_13[n].feature>=0){ const MiloNode &v=MILO_TREE_13[n];n=x[v.feature]<=v.threshold?v.left:v.right;}score+=MILO_TREE_13[n].score;}
{ int n=0; while(MILO_TREE_14[n].feature>=0){ const MiloNode &v=MILO_TREE_14[n];n=x[v.feature]<=v.threshold?v.left:v.right;}score+=MILO_TREE_14[n].score;}
{ int n=0; while(MILO_TREE_15[n].feature>=0){ const MiloNode &v=MILO_TREE_15[n];n=x[v.feature]<=v.threshold?v.left:v.right;}score+=MILO_TREE_15[n].score;}
{ int n=0; while(MILO_TREE_16[n].feature>=0){ const MiloNode &v=MILO_TREE_16[n];n=x[v.feature]<=v.threshold?v.left:v.right;}score+=MILO_TREE_16[n].score;}
{ int n=0; while(MILO_TREE_17[n].feature>=0){ const MiloNode &v=MILO_TREE_17[n];n=x[v.feature]<=v.threshold?v.left:v.right;}score+=MILO_TREE_17[n].score;}
{ int n=0; while(MILO_TREE_18[n].feature>=0){ const MiloNode &v=MILO_TREE_18[n];n=x[v.feature]<=v.threshold?v.left:v.right;}score+=MILO_TREE_18[n].score;}
{ int n=0; while(MILO_TREE_19[n].feature>=0){ const MiloNode &v=MILO_TREE_19[n];n=x[v.feature]<=v.threshold?v.left:v.right;}score+=MILO_TREE_19[n].score;}
{ int n=0; while(MILO_TREE_20[n].feature>=0){ const MiloNode &v=MILO_TREE_20[n];n=x[v.feature]<=v.threshold?v.left:v.right;}score+=MILO_TREE_20[n].score;}
{ int n=0; while(MILO_TREE_21[n].feature>=0){ const MiloNode &v=MILO_TREE_21[n];n=x[v.feature]<=v.threshold?v.left:v.right;}score+=MILO_TREE_21[n].score;}
{ int n=0; while(MILO_TREE_22[n].feature>=0){ const MiloNode &v=MILO_TREE_22[n];n=x[v.feature]<=v.threshold?v.left:v.right;}score+=MILO_TREE_22[n].score;}
{ int n=0; while(MILO_TREE_23[n].feature>=0){ const MiloNode &v=MILO_TREE_23[n];n=x[v.feature]<=v.threshold?v.left:v.right;}score+=MILO_TREE_23[n].score;}
return score/24.0f;
}
