nitin19011/milo-hardware/firmware/history/two_finger_demo_20261022/GloveDemo/GloveDemo.ino

// 22 Oct demo workaround in GloveApp.h: thumb/index trigger only; middle always 0.
#include "DemoConfig.h"
#include "DemoRuntime.h"
#include "GloveApp.h"
void setup(){gloveSetup();}
void loop(){gloveLoop();}
